jcaf/Atmega328P-TermocuplaJ-INA129_o_MAX31856/PCB/termocuplaJ v2/pinout ard nano.png

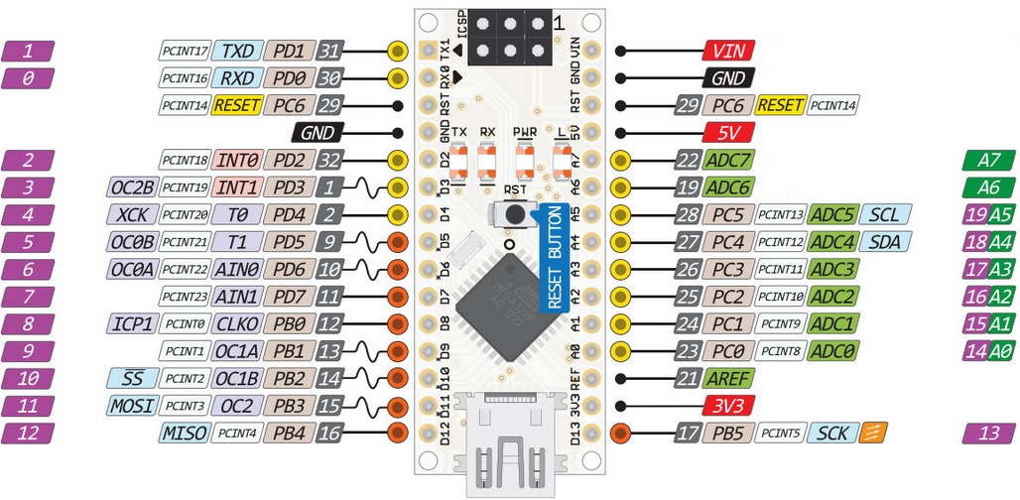
PCB/termocuplaJ v2/pinout ard nano.png
