jcaf/Atmega328P-TermocuplaJ-INA129_o_MAX31856/11-PIN-SOCKET PINOUT.ods

 | 11-PINS SOCKET PINOUT
1 | T+ | TERMOCUPLA
2 | T-
3 | +24VDC (PULSO) | NUEVA_PIEZA
4 | C.C | RELAY1 CONTROL PID
5 | N.O
6 | C.C | RELAY 2 3 POSICIONES
7 | N.O
8 | N.C
9 | +24VDC (PULSO) | RESET
10 | +24VDC | POWER 24VDC
11 | GND
