jcaf/Atmega328P-TermocuplaJ-INA129_o_MAX31856/COSTOS/costos sr antonio.ods

Sheet: Sheet1
atmega | 12 | 1 | 12
ina | 30 | 1 | 30
lm | 1.5 | 1 | 1.5
fuente | 7 | 1 | 7
relays | 8 | 2 | 16
elec | 10 | 1 | 10
pcb | 15 | 1 | 15
 |  |  | 91.5 | 680
 |  |  | 25
 |  | gain | 50
servicio de disno |  |  | 100

Sheet: Sheet2
3.3 | DOLAR | SOLES
atmega |  | 10 | 1 | 10
MAX3186 | 4.73 | 15.609 | 1 | 15.609
LM7805 |  |  |  | 1.5
fuente |  | 7 | 1 | 7
relays |  | 1.3 | 2 | 2.6
elec |  | 5 | 1 | 5
pcb |  | 8 | 1 | 8
COSTO COMPONENTES |  |  |  | 49.709 | 680
ENSAMBLAJE |  |  |  | 25
TOTAL |  |  |  | 74.709
servicio de disno |  |  |  | 100

Sheet: Sheet3
3.3 | DOLAR | SOLES |  |  | extra
atmega |  | 10 | 1 | 10 | 30 | recoger
MAX31856 | 4.73 | 15.609 | 1 | 15.609 | 70 | flete
LM7805 |  |  |  | 1.5
fuente |  | 7 | 1 | 7 | 10 | adaptacion
relays |  | 1.3 | 2 | 2.6
elec |  | 5 | 1 | 5
pcb |  | 12 | 1 | 12 | 30
COSTO COMPONENTES |  |  |  | 53.709 |  | 680
ENSAMBLAJE |  |  |  | 25
TOTAL |  |  |  | 78.709 | 140
EXTRA |  |  |  | 35
 |  |  |  | 113.709
servicio de disno |  |  |  | 100
 |  |  |  | 680
 |  |  |  | 800

Sheet: Sheet4
Sr. ANTONIO CASTILLO
 | # | COSTO UNITARIO | SUBTOTAL
DISEÑO 1 PCB PRINCIPAL | 1 | 100 | 100
COSTO TARJETA CONTROL 4 UNIDADES | 4 | 205 | 820
 |  |  | 0
 |  |  | 0
DISEÑO Y ENSAMBLAJE TARJETA EXTERNA LCD+TECLADO+ CABLE IDC | 1 | 50 | 50
ADAPTACION A LA CARCASA |  |  | 80
 |  |  | 0
 |  | TOTAL | 1050
 |  | A Cta. 500+250 | 750
 |  | RESTA | 300
