jcaf/Atmega328P-TermocuplaJ-INA129_o_MAX31856/PCB/termocuplaJ v2/termocuplaJ.pdf

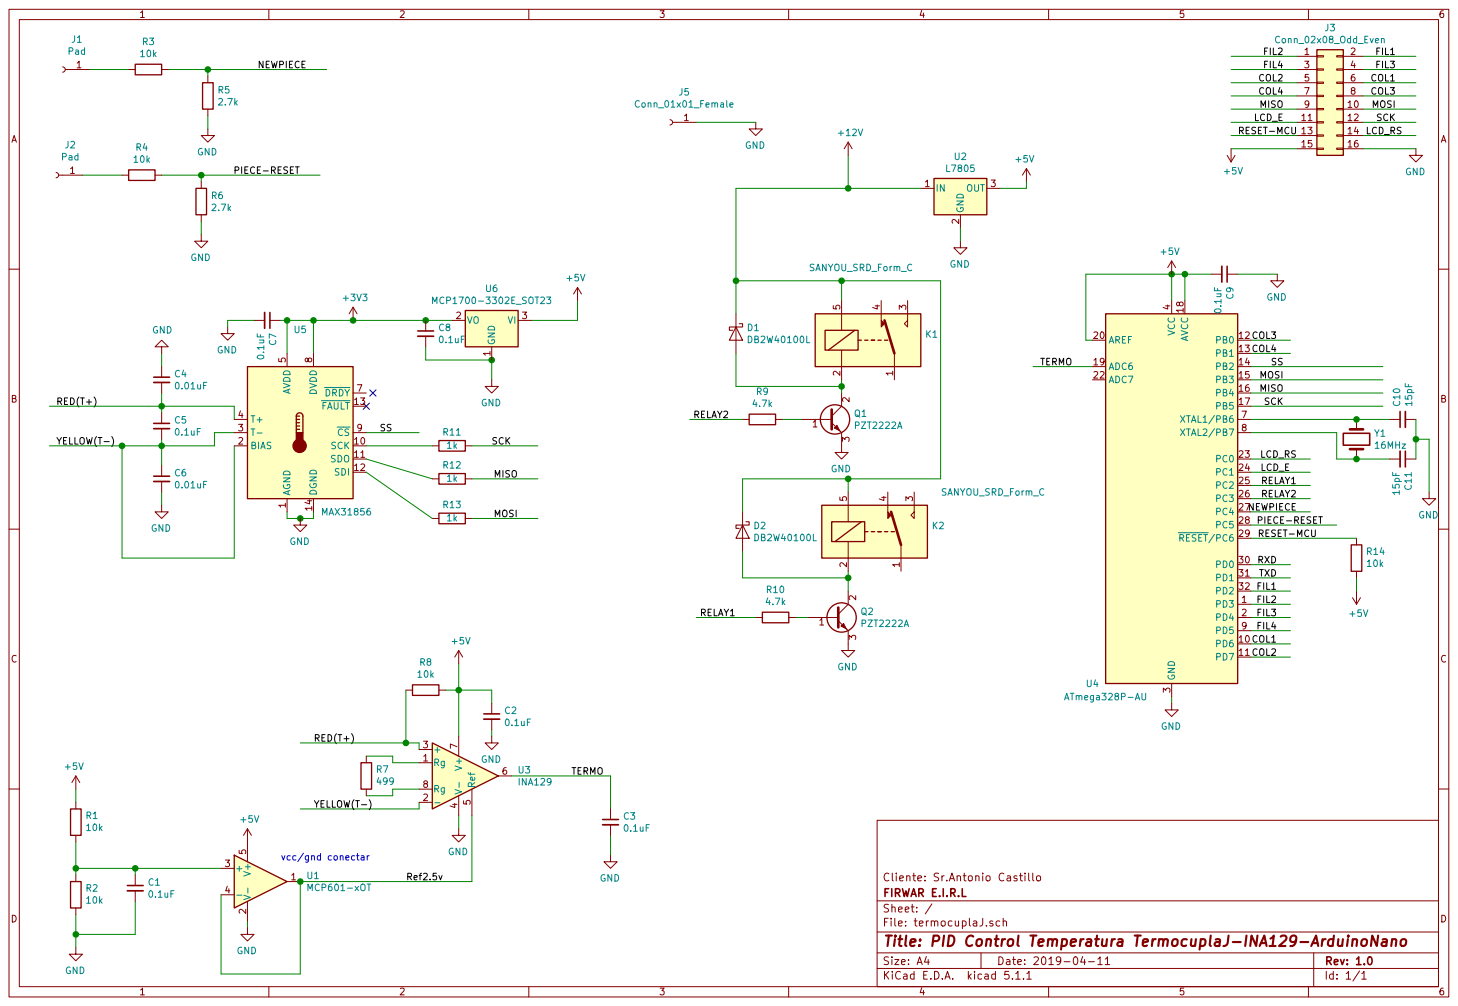
[picture p2: page 1]

FIL1 FIL2 FIL3 FIL4 COL1 COL2 COL3 COL4
SCK MISO MOSI SS RXD

1 SCK 10 SDO 11 SDI 12 FAULT 13 DGND 14 BIAS 2 T- 3 T+ 4 AVDD

File: termocuplaJ.sch Sheet: / FIRWAR E.I.R.L Cliente: Sr.Antonio Castillo

Id: 1/1 Title: PID Control Temperatura TermocuplaJ-INA129-ArduinoNano
