jcaf/Atmega328P-TermocuplaJ-INA129_o_MAX31856/PCB/termocuplaJ v2/ARTES/Arte-Serigrafia copy.pdf

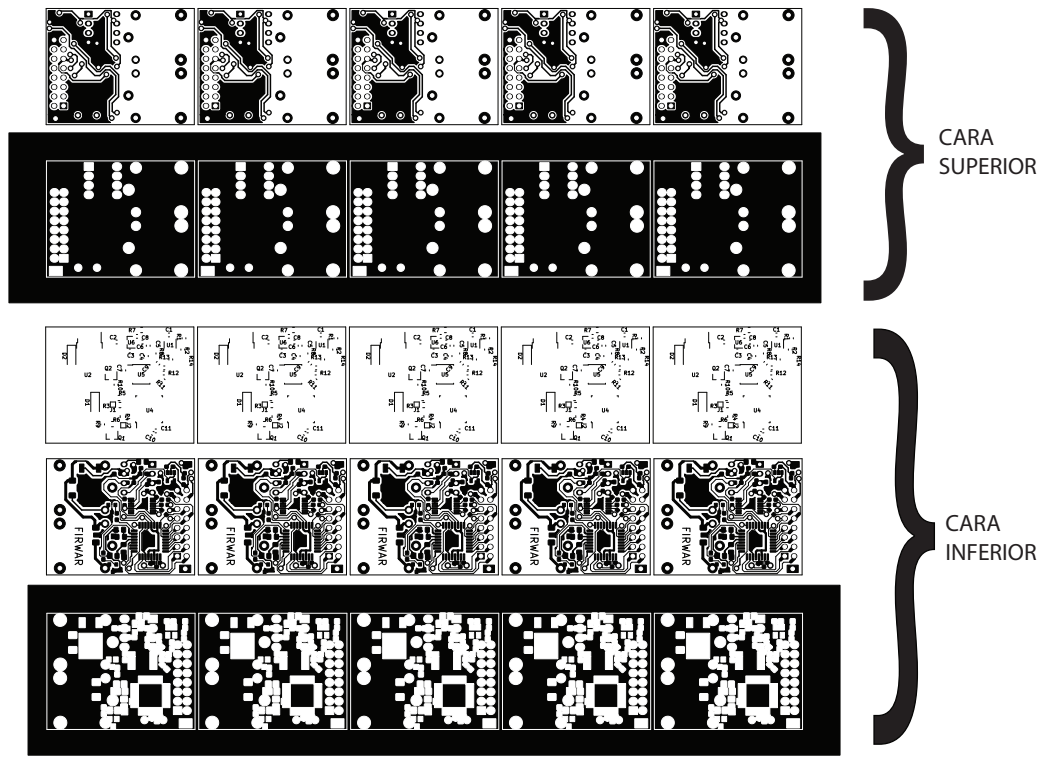
[picture p3: page 1]
CARA SUPERIOR; CARA INFERIOR
