jcaf/Atmega328P-TermocuplaJ-INA129_o_MAX31856/PCB/termocuplaJ v2/ARTES/PDF/termocuplaJ-B_Mask.pdf

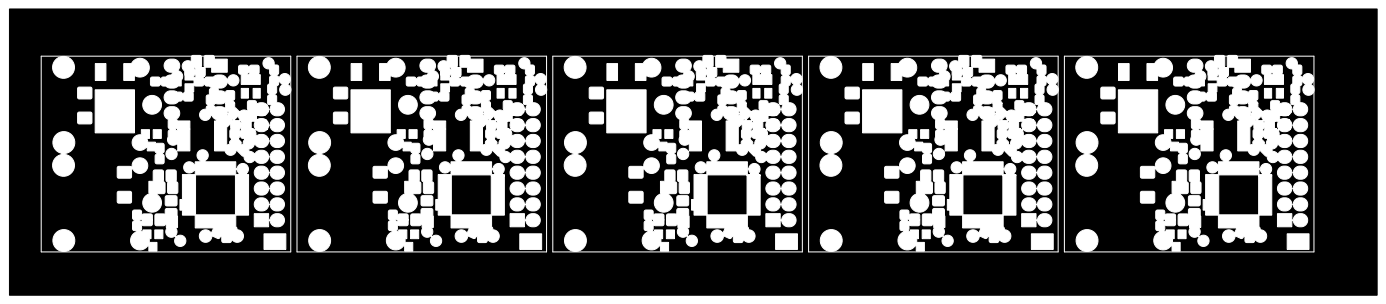
[picture p4: page 1]
