jcaf/Atmega328P-TermocuplaJ-INA129_o_MAX31856/PCB/termocuplaJ v2/ARTES/PDF/termocuplaJ-B_SilkS.pdf

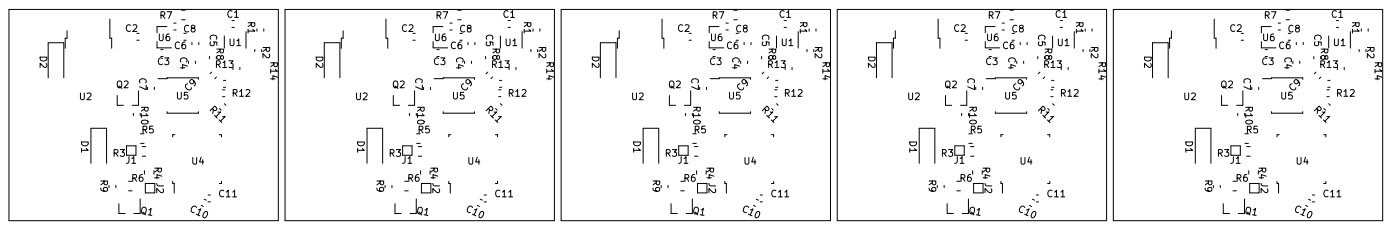
[picture p5: page 1]
