jcaf/Atmega328P-TermocuplaJ-INA129_o_MAX31856/PCB/termocuplaJ v2/ARTES/PDF/termocuplaJ-Edge_Cuts.pdf

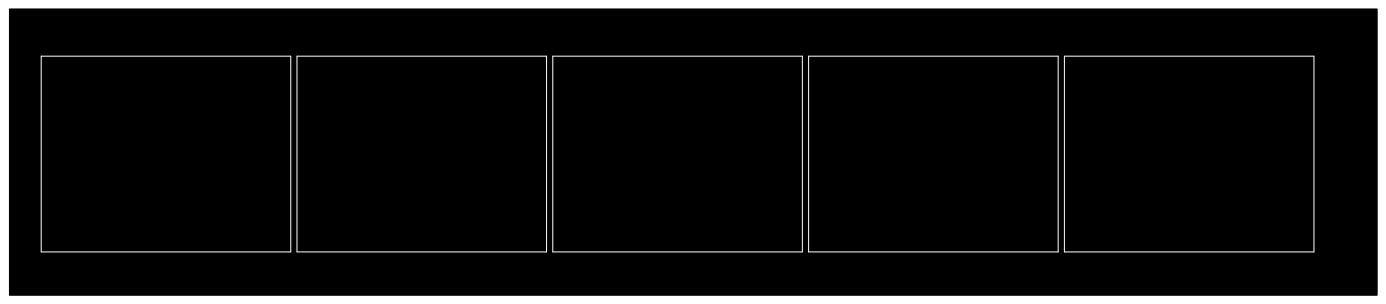
[picture p6: page 1]
