jcaf/Atmega328P-TermocuplaJ-INA129_o_MAX31856/PCB/termocuplaJ v2/ARTES/PDF/termocuplaJ-F_Cu.pdf

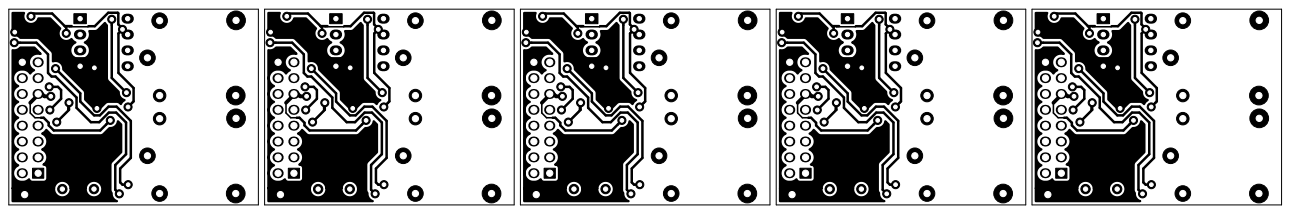
[picture p7: page 1]
