jcaf/Atmega328P-TermocuplaJ-INA129_o_MAX31856/PCB/termocuplaJ v2/ARTES/PDF/termocuplaJ-F_Mask.pdf

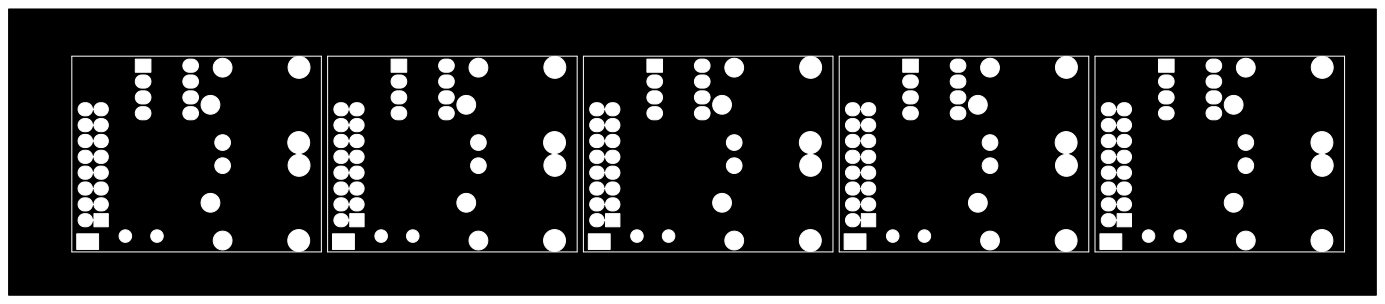
[picture p8: page 1]
