jcaf/Atmega328P-TermocuplaJ-INA129_o_MAX31856/PCB/EXT_LCD+TECLADO/EXT_LCD+TECLADO.kicad_pcb

## KiCad design PCB/EXT_LCD+TECLADO/EXT_LCD+TECLADO.kicad_pcb (2019-04-30)

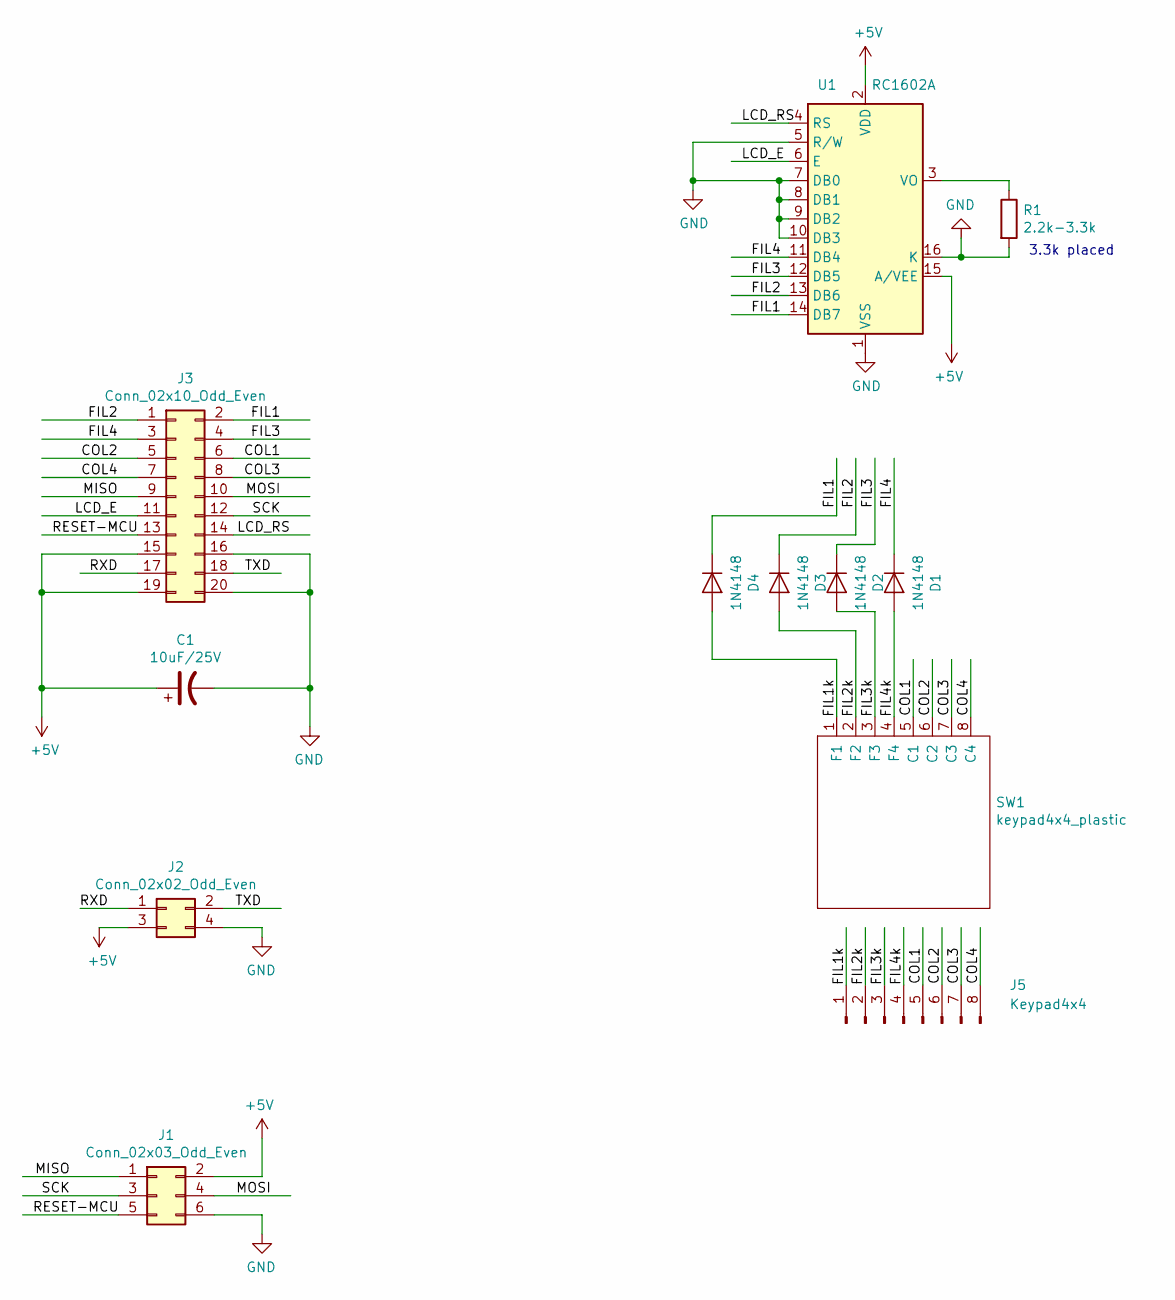
[picture p10: schematic EXT_LCD+TECLADO.sch]

Parts:
C1: 10uF/25V; CP_Radial_D5.0mm_P2.50mm
D1, D2, D3, D4: 1N4148; D_DO-35_SOD27_P7.62mm_Horizontal
J1: Conn_02x03_Odd_Even; IDC-Header_2x03_P2.54mm_Vertical
J2: Conn_02x02_Odd_Even; PinHeader_2x02_P2.54mm_Vertical
J3: Conn_02x10_Odd_Even; IDC-Header_2x10_P2.54mm_Vertical_Lock
J5: Keypad4x4; PinHeader_1x08_P2.54mm_Vertical
R1: 2.2k-3.3k; R_Axial_DIN0207_L6.3mm_D2.5mm_P10.16mm_Horizontal
SW1: keypad4x4_plastic
U1: RC1602A; WC1602A

Connections:
+5V: C1.1, J1.2, J2.3, J3.15, J3.19, U1.2 (VDD), U1.15 (A/VEE)
/COL1: J3.6, J5.5, SW1.5 (C1)
/COL2: J3.5, J5.6, SW1.6 (C2)
/COL3: J3.8, J5.7, SW1.7 (C3)
/COL4: J3.7, J5.8, SW1.8 (C4)
/FIL1: D4.1 (K), J3.2, U1.14 (DB7)
/FIL1k: D4.2 (A), J5.1, SW1.1 (F1)
/FIL2: D3.1 (K), J3.1, U1.13 (DB6)
/FIL2k: D3.2 (A), J5.2, SW1.2 (F2)
/FIL3: D2.1 (K), J3.4, U1.12 (DB5)
/FIL3k: D2.2 (A), J5.3, SW1.3 (F3)
/FIL4: D1.1 (K), J3.3, U1.11 (DB4)
/FIL4k: D1.2 (A), J5.4, SW1.4 (F4)
/LCD_E: J3.11, U1.6 (E)
/LCD_RS: J3.14, U1.4 (RS)
/MISO: J1.1, J3.9
/MOSI: J1.4, J3.10
/RESET-MCU: J1.5, J3.13
/RXD: J2.1, J3.17
/SCK: J1.3, J3.12
/TXD: J2.2, J3.18
GND: C1.2, J1.6, J2.4, J3.16, J3.20, R1.2, U1.1 (VSS), U1.5 (R/W), U1.7 (DB0), U1.8 (DB1), U1.9 (DB2), U1.10 (DB3), U1.16 (K)
unnamed: R1.1, U1.3 (VO)

Notes on the sheet:
3.3k placed

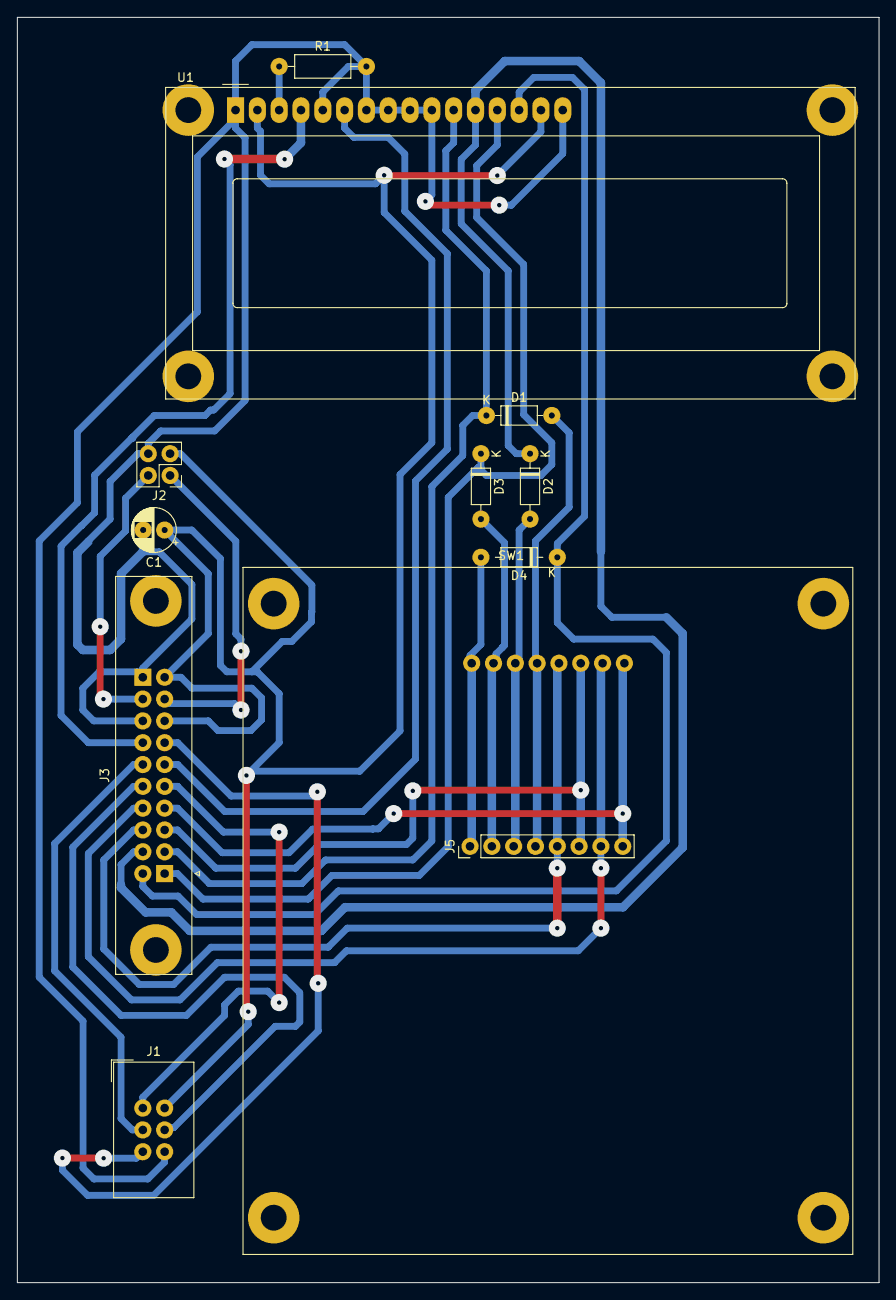
[picture p11: board EXT_LCD+TECLADO.kicad_pcb from above]

Board: 2 copper layers, 100.3 x 147.3 mm, 12 parts (0 on the bottom side), 23 nets.
