jcaf/Atmega328P-TermocuplaJ-INA129_o_MAX31856/Atmega328P+TermocuplaJ-INA129_o_MAX31856/src/ikey/kb.c

#include "../system.h"
#include "ikey.h"
#include "kb.h"


//////// KEYPAD 4X4 //////////////////////
//////////////////////////////////////KEY1
#define PORTWxKBFIL_KEY1 	PORTWxKBFIL_1
#define PORTRxKBFIL_KEY1 	PORTRxKBFIL_1
#define CONFIGIOxKBFIL_KEY1 	CONFIGIOxKBFIL_1
#define PINxKBFIL_KEY1 		PINxKBFIL_1
//
#define PORTWxKBCOL_KEY1 	PORTWxKBCOL_1
#define PORTRxKBCOL_KEY1 	PORTRxKBCOL_1
#define CONFIGIOxKBCOL_KEY1 	CONFIGIOxKBCOL_1
#define PINxKBCOL_KEY1 		PINxKBCOL_1
//////////////////////////////////////KEY2
#define PORTWxKBFIL_KEY2 	PORTWxKBFIL_1
#define PORTRxKBFIL_KEY2 	PORTRxKBFIL_1
#define CONFIGIOxKBFIL_KEY2 	CONFIGIOxKBFIL_1
#define PINxKBFIL_KEY2 		PINxKBFIL_1
//
#define PORTWxKBCOL_KEY2 	PORTWxKBCOL_2
#define PORTRxKBCOL_KEY2 	PORTRxKBCOL_2
#define CONFIGIOxKBCOL_KEY2 	CONFIGIOxKBCOL_2
#define PINxKBCOL_KEY2 		PINxKBCOL_2
//////////////////////////////////////
#define PORTWxKBFIL_KEY3 	PORTWxKBFIL_1
#define PORTRxKBFIL_KEY3 	PORTRxKBFIL_1
#define CONFIGIOxKBFIL_KEY3 	CONFIGIOxKBFIL_1
#define PINxKBFIL_KEY3 		PINxKBFIL_1
//
#define PORTWxKBCOL_KEY3 	PORTWxKBCOL_3
#define PORTRxKBCOL_KEY3 	PORTRxKBCOL_3
#define CONFIGIOxKBCOL_KEY3 	CONFIGIOxKBCOL_3
#define PINxKBCOL_KEY3 		PINxKBCOL_3
//////////////////////////////////////
#define PORTWxKBFIL_KEY4 	PORTWxKBFIL_1
#define PORTRxKBFIL_KEY4 	PORTRxKBFIL_1
#define CONFIGIOxKBFIL_KEY4 	CONFIGIOxKBFIL_1
#define PINxKBFIL_KEY4 		PINxKBFIL_1
//
#define PORTWxKBCOL_KEY4 	PORTWxKBCOL_4
#define PORTRxKBCOL_KEY4 	PORTRxKBCOL_4
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
    {
        kb_clear_ready2read(13);
        //kb_execfunct(13);
    }
    if (kb_get_ready2read(14))
    {
        kb_clear_ready2read(14);
        //kb_execfunct(14);
    }
    if (kb_get_ready2read(15))
    {
        kb_clear_ready2read(15);
        //kb_execfunct(15);
    }

}
*/
void kb_job(void)
{
    ikey_scan();
    ikey_parsing();
}
void kb_flush(void)
{
    ikey_all_clear_flag();
}
/*
void kb_change_keyDo_pgm(PTRFX_retVOID const *  keyDo)
{
    uint8_t i;
    for (i=0; i<KB_NUM_KEYS; i++)
        key[i].keyDo = (PTRFX_retVOID)pgm_read_word(&keyDo[i]);
}
 */
/*
void kb_change_keyDo(PTRFX_retVOID *keyDo)
{
    uint8_t i;
    for (i=0; i<KB_NUM_KEYS; i++)
        key[i].keyDo = keyDo[i];
}
*/
/*
void kb_change_keyDo(const PTRFX_retVOID *keyDo)
{
    uint8_t i;
    for (i=0; i<KB_NUM_KEYS; i++)
        key[i].keyDo = keyDo[i];
}
*/
