jcaf/Atmega328P-TermocuplaJ-INA129_o_MAX31856/Atmega328P+TermocuplaJ-INA129_o_MAX31856/src/types.h

#ifndef TYPES_H_
#define TYPES_H_

#include <stdint-gcc.h>

typedef uint8_t(*PTRFX_retUINT8_T)(void);
typedef uint16_t(*PTRFX_retUINT16_T)(void);
typedef void (*PTRFX_retVOID)(void);
typedef void (*PTRFX_retVOID_arg1_UINT8_T)(uint8_t);
typedef void (*PTRFX_retVOID_arg1_INT8_T)(int8_t);
typedef void (*PTRFX_retVOID_arg1_PCHAR)(char *);
typedef unsigned char BOOL;


#endif // TYPES_H_
