jcaf/Atmega328P-TermocuplaJ-INA129_o_MAX31856/(commit log)

2019-04-30 Antes de intercambiar Relay1 y Relay2. Para minimizar los arcos producidos por los relays Todo lo demas ok.
    [EXT_LCD+TECLADO.kicad_pcb, EXT_LCD+TECLADO.sch, costos sr antonio.ods, termocuplaJ.kicad_pcb, termocuplaJ.sch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]
2019-04-30 INtercambiando relay1 y relay2...
2019-04-30 Corregido el bug de salir del menu y reseteaba el contador de minutos. Este hex es el que ha sido grabado a los 3 cktos con sus respectivo MAX31856
    [lcdan_aux.h, main.c]
2019-05-01 nueva calibracion de ktes PID OK probado con el INA129
2019-05-01 FINAL ENTREGADO
    [termocuplaJ.sch]
2019-05-01 11-PINS SOCKET PINOUT
    [11-PIN-SOCKET PINOUT.ods]
